splinedrive/gf180mcu-kianv-pcb/3dmodels/DF40C-70DS--3DModel-STEP-1.STEP

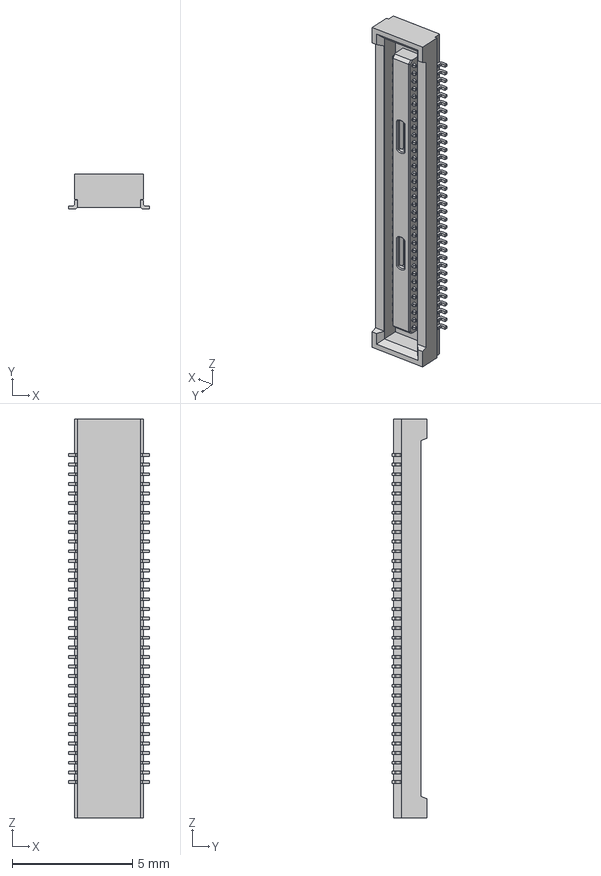
[picture p1: CAD file, 2026-02-03]
3dmodels/DF40C-70DS--3DModel-STEP-1.STEP
3.38 x 1.45 x 16.6 mm
