splinedrive/gf180mcu-kianv-pcb/3dmodels/5033981892--3DModel-STEP-1.STEP

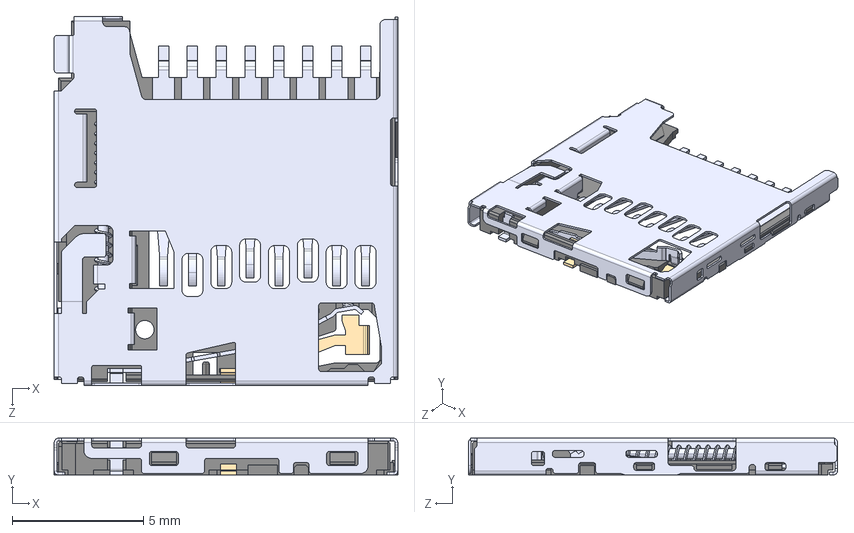
[picture p2: CAD file, 2026-02-03]
3dmodels/5033981892--3DModel-STEP-1.STEP
13.1 x 1.40 x 14.1 mm
