splinedrive/gf180mcu-kianv-pcb/3dmodels/2201778-1--3DModel-STEP-78480.STEP

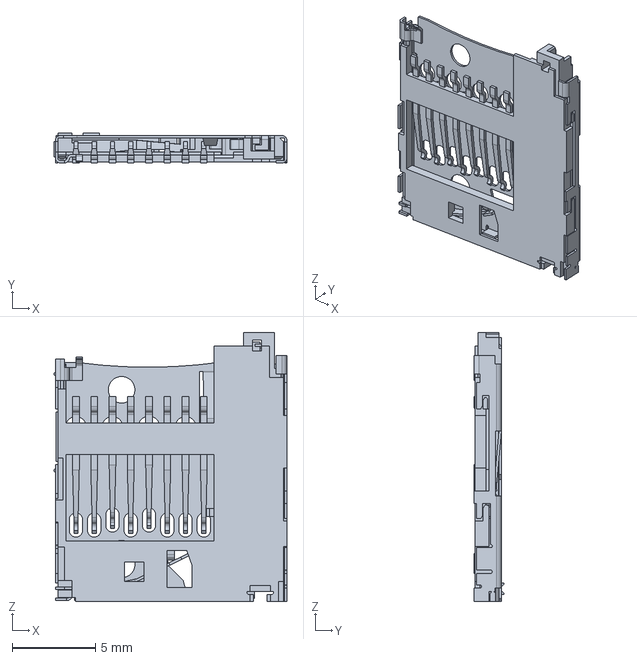
[picture p3: CAD file, 2026-02-03]
3dmodels/2201778-1--3DModel-STEP-78480.STEP
14.0 x 1.80 x 16.2 mm
