splinedrive/gf180mcu-kianv-pcb/gf180mcu-linux-KianV-SoC.kicad_pcb

## KiCad design gf180mcu-linux-KianV-SoC.kicad_pcb (2026-06-17)

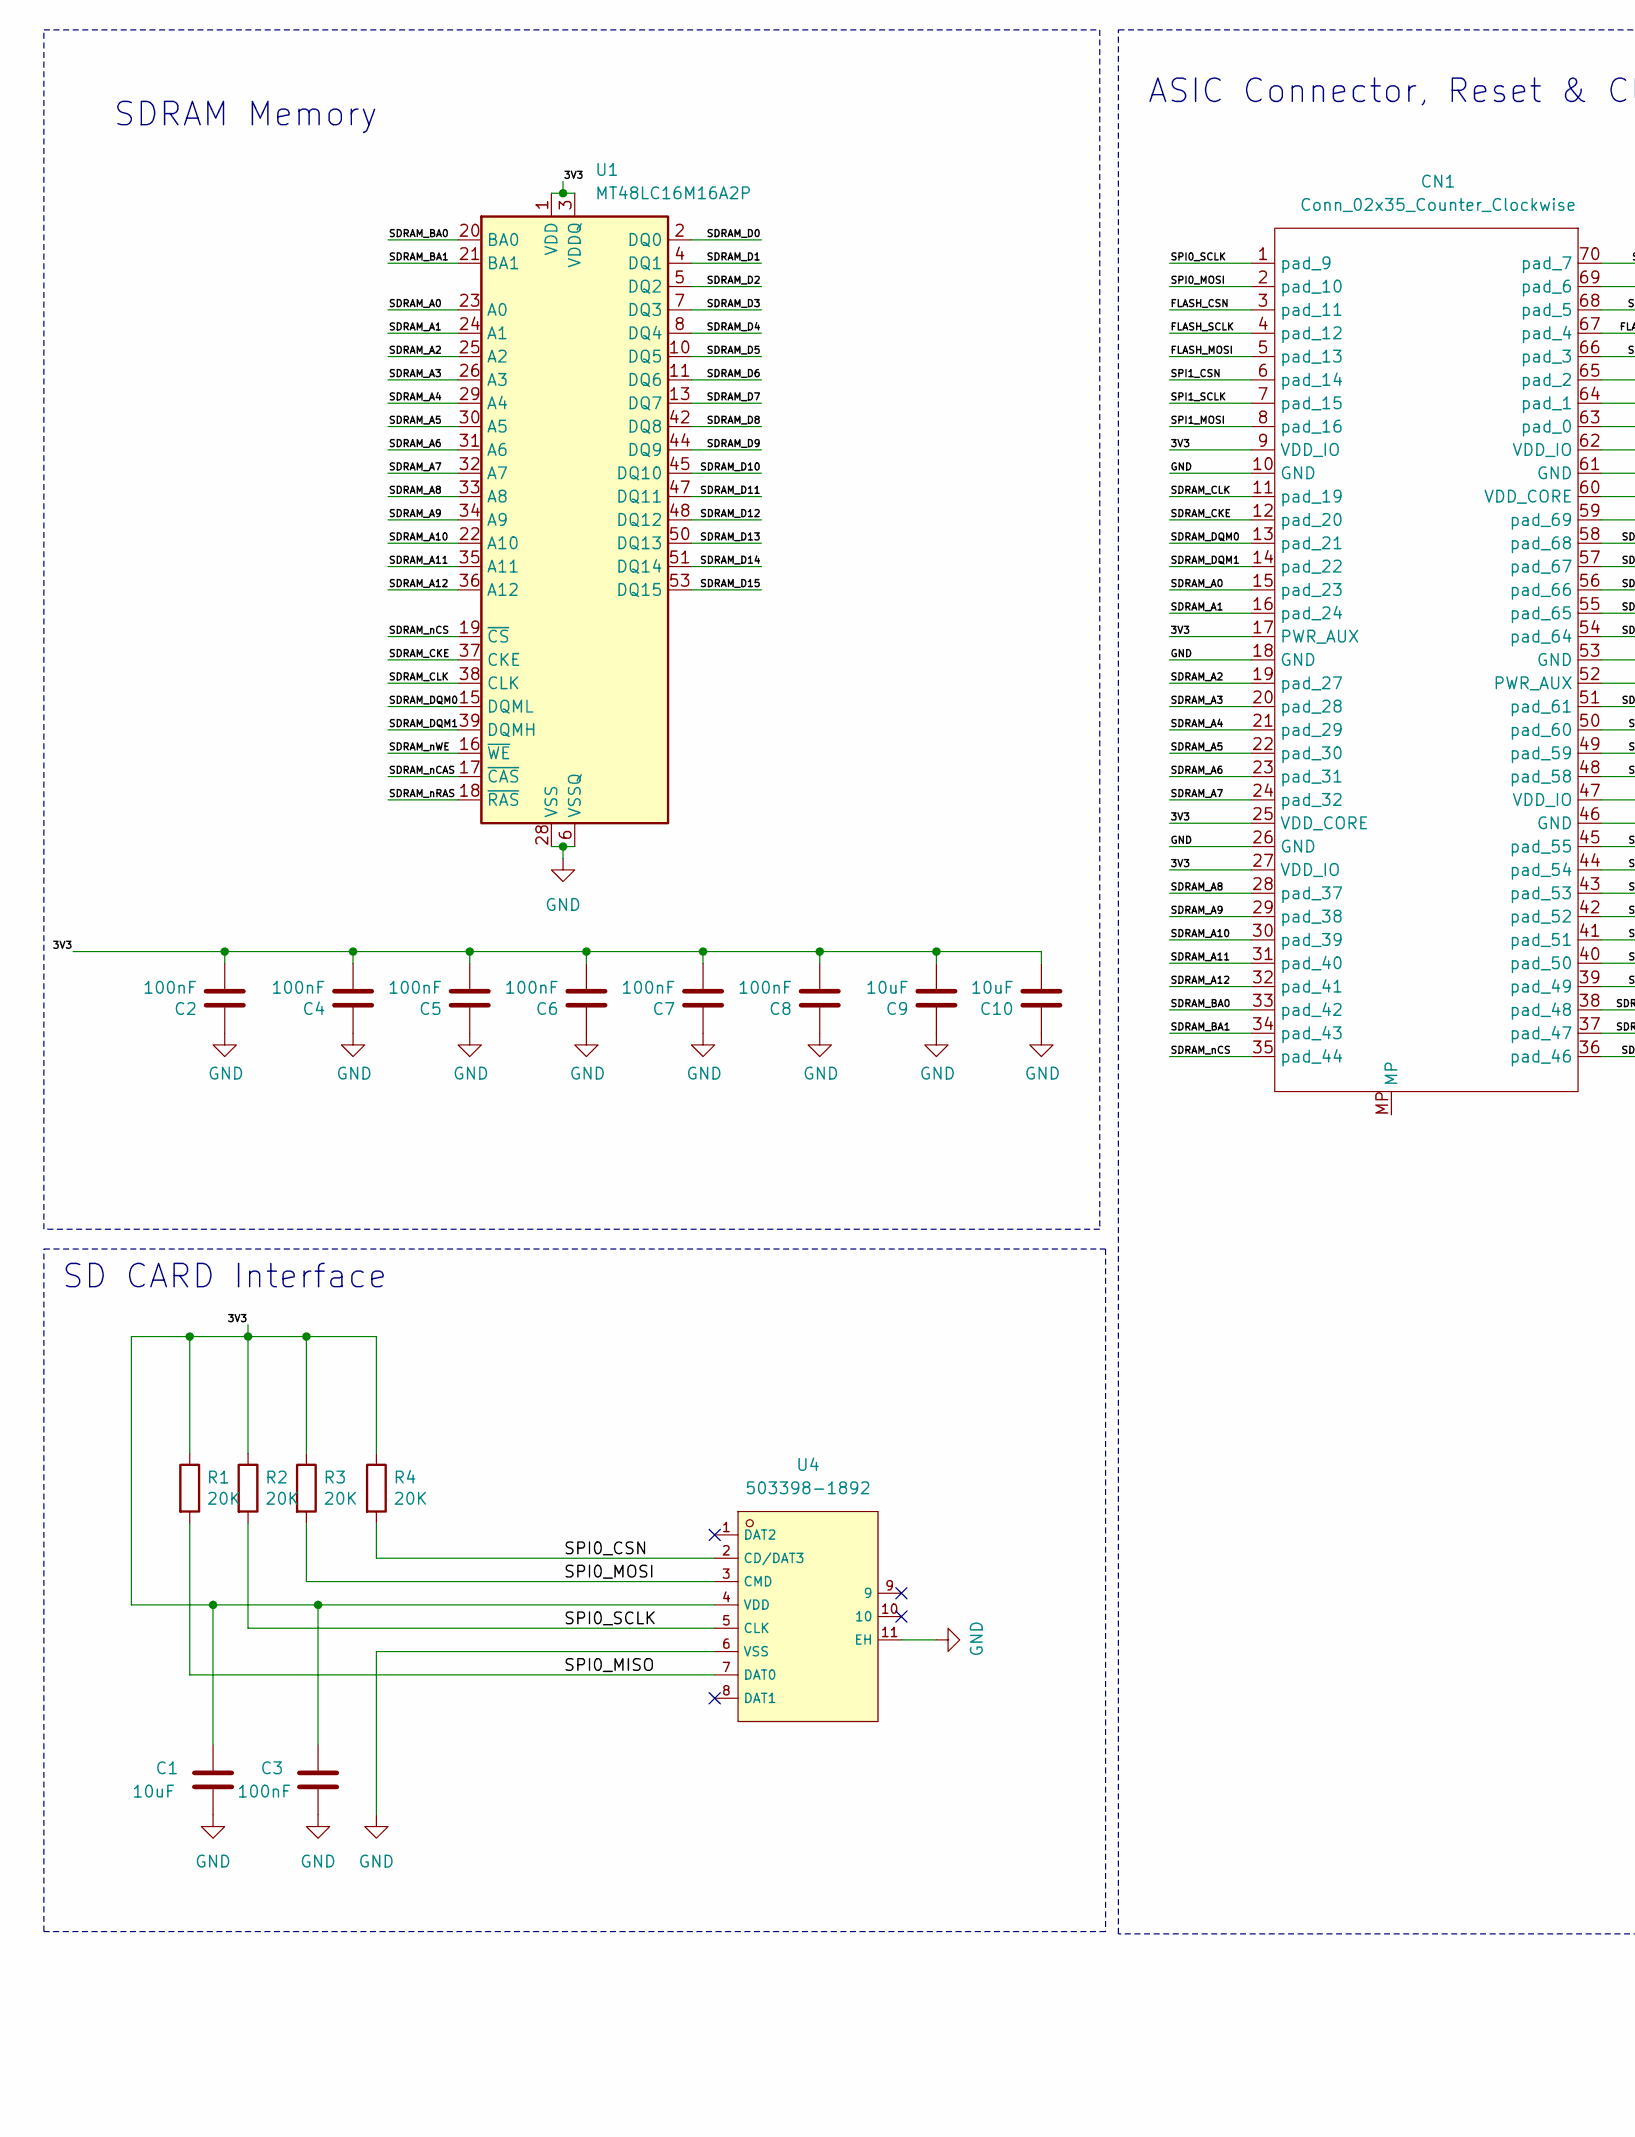
[picture p4: schematic gf180mcu-linux-KianV-SoC.kicad_sch, part in row 1, column 1]

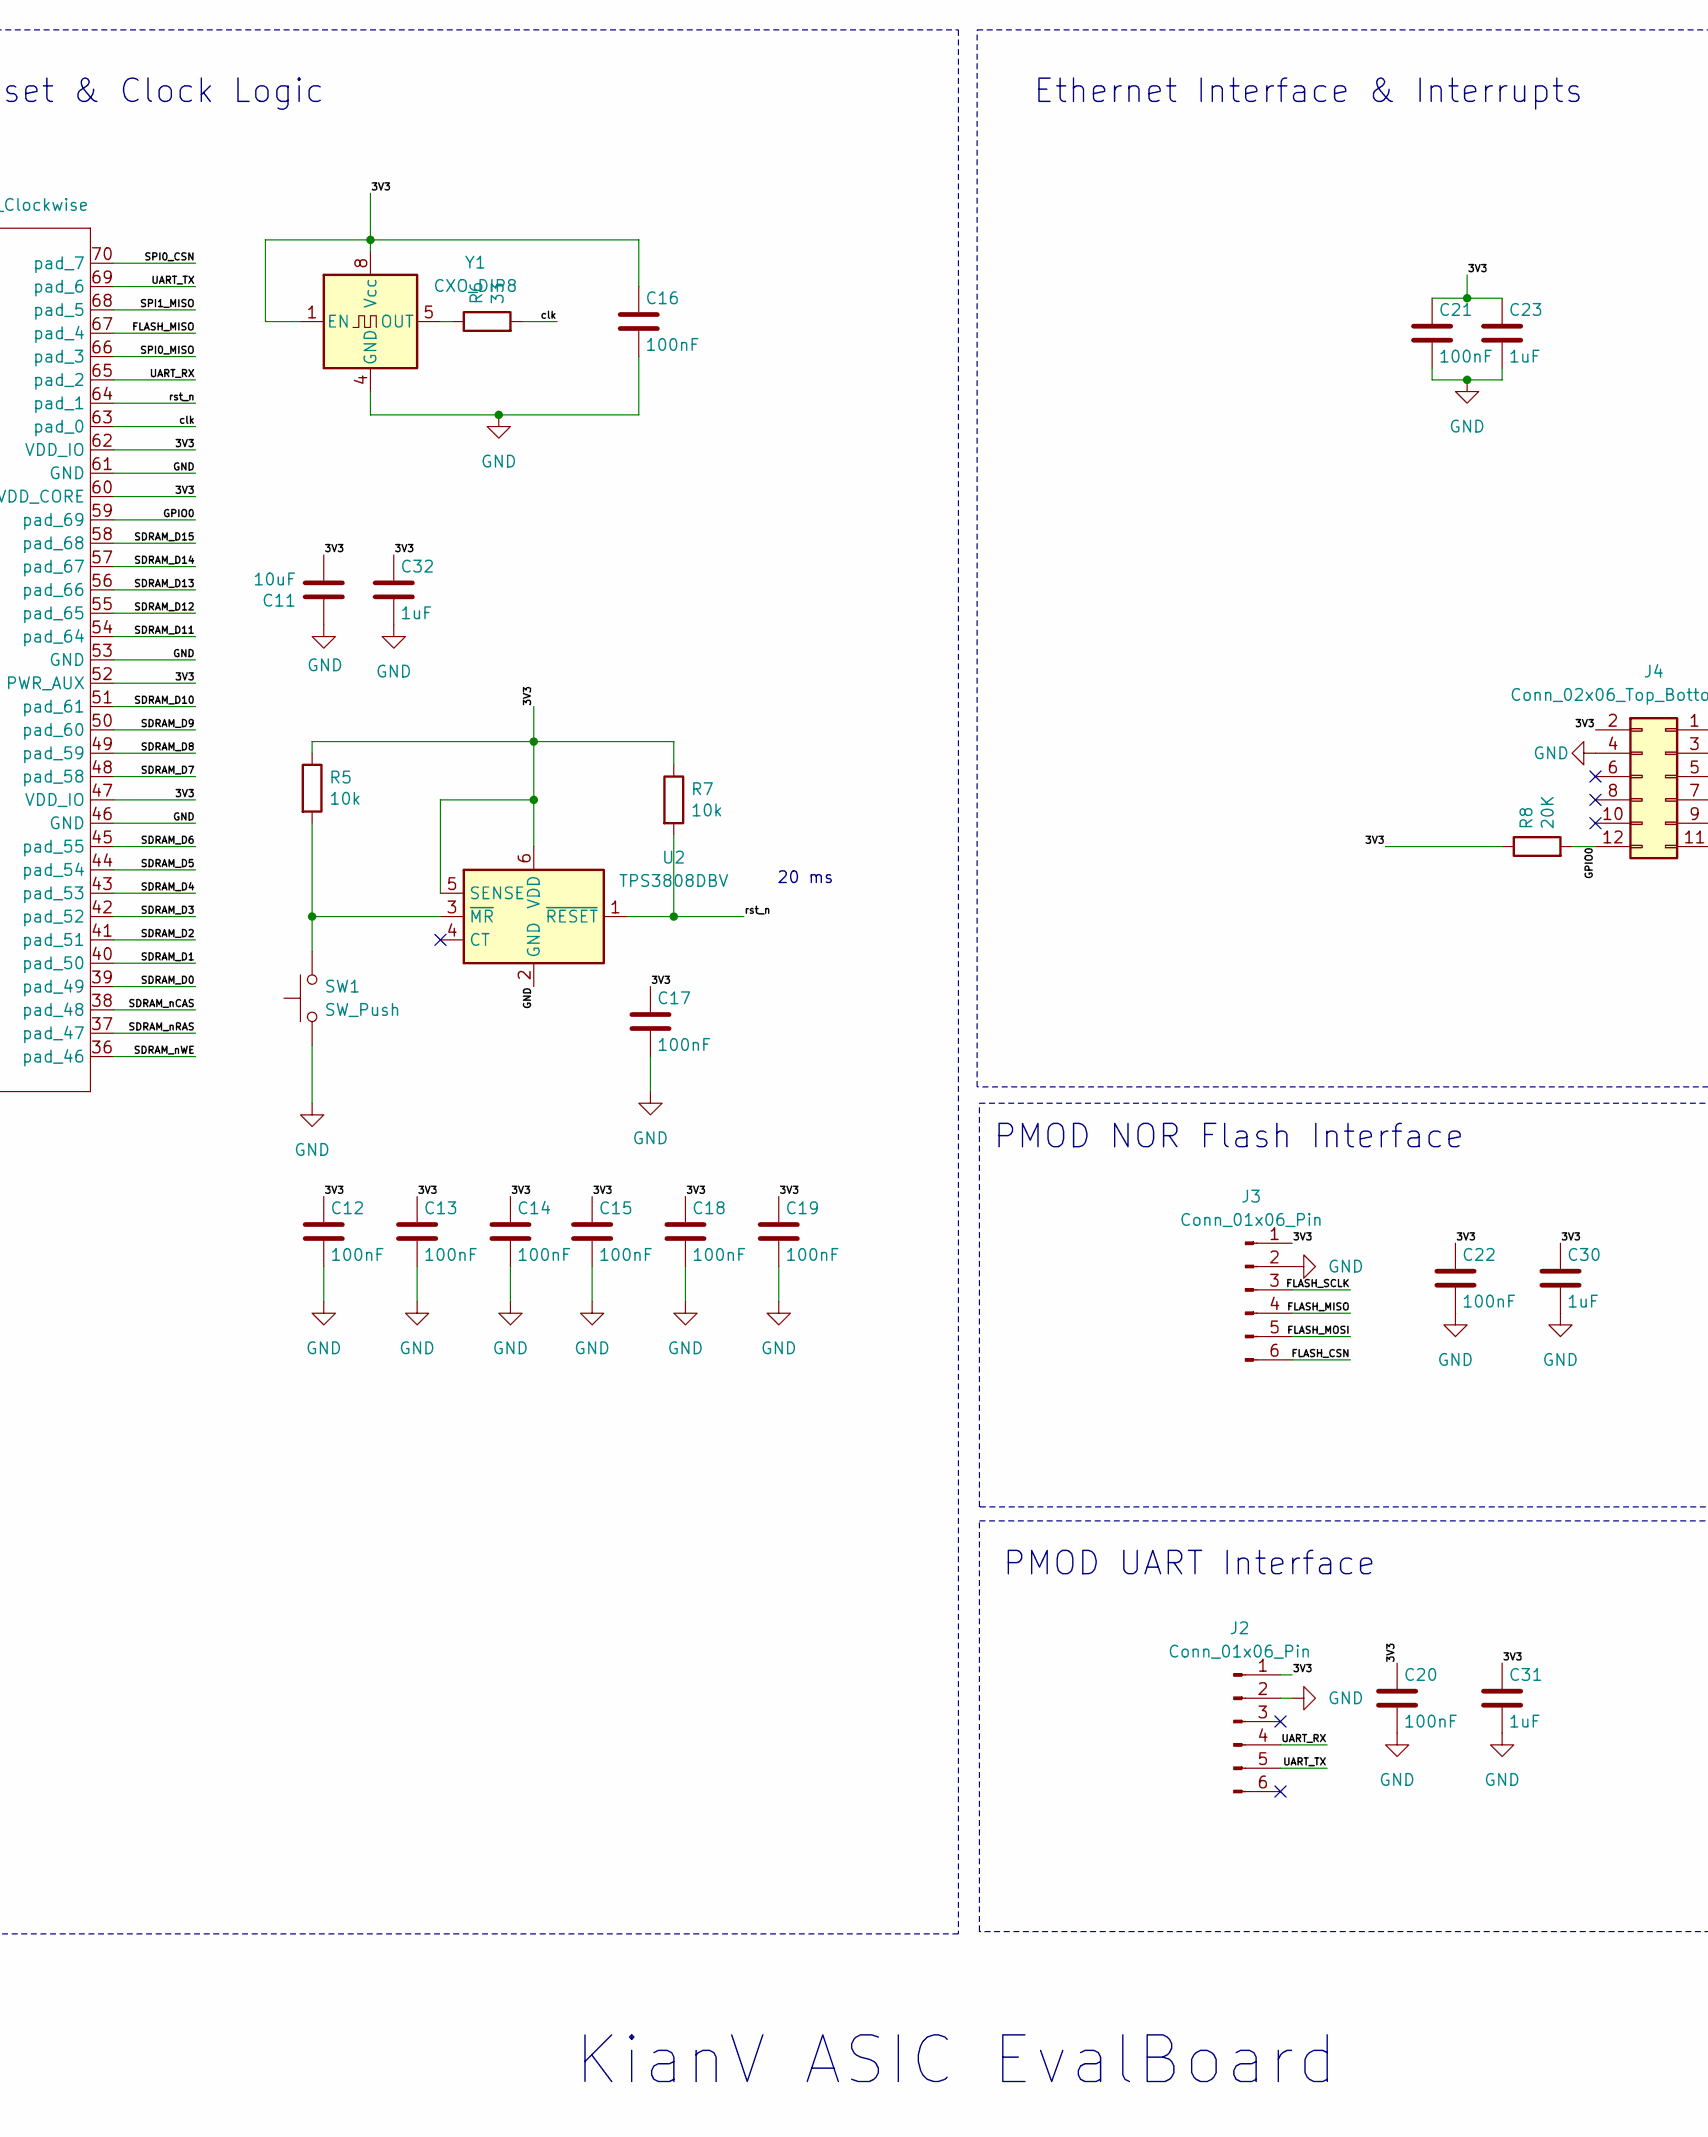
[picture p5: schematic gf180mcu-linux-KianV-SoC.kicad_sch, part in row 1, column 2]

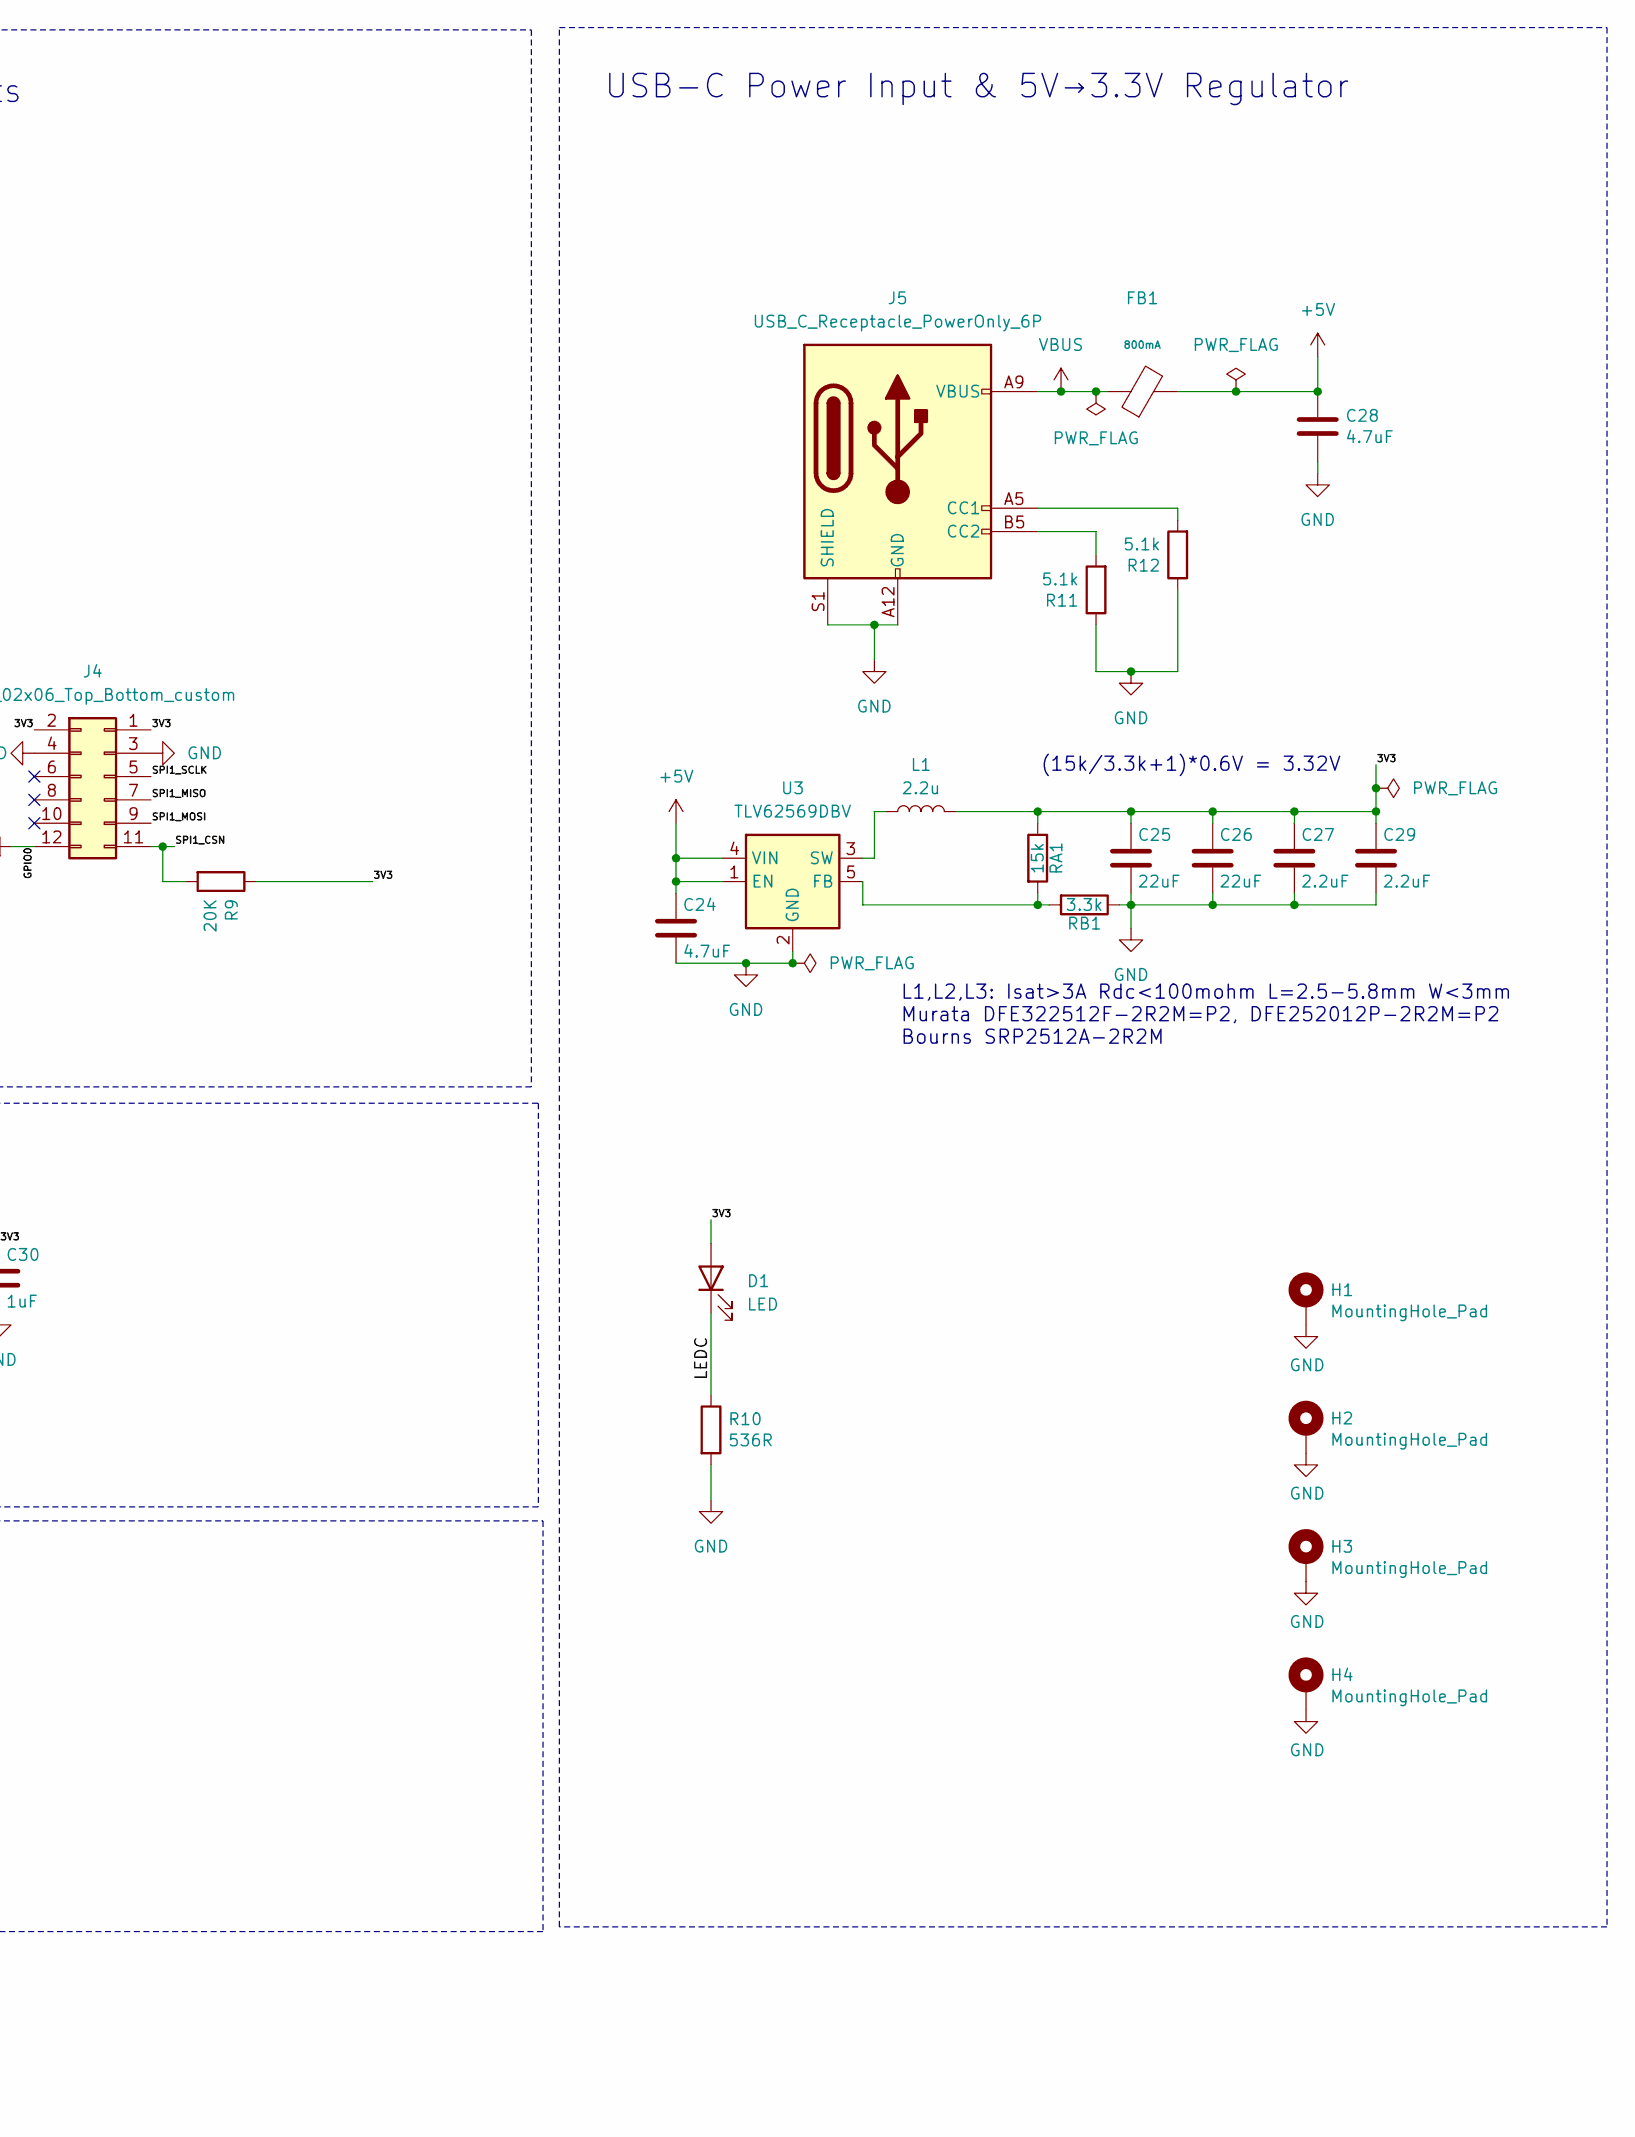
[picture p6: schematic gf180mcu-linux-KianV-SoC.kicad_sch, part in row 1, column 3]

Parts:
C1: 10uF; C_0603
C2, C3, C4, C5, C6, C7, C8: 100nF; C_0603_1608Metric
C9, C10, C11: 10uF; C_0603_1608Metric
C12, C13, C14, C15, C16, C17, C18, C19, C20, C21, C22: 100nF; C_0603_1608Metric; MPN CX0603MRX7R8BB223
C23, C30, C31, C32: 1uF; C_0603_1608Metric; MPN CX0603MRX7R8BB223
C24: 4.7uF; C_0805_2012Metric
C25, C26: 22uF; C_0805_2012Metric
C27, C29: 2.2uF; C_0805_2012Metric
C28: 4.7uF; C_0603_1608Metric
CN1: Conn_02x35_Counter_Clockwise; CONN-SMD_70P-P0.40_HC-PBB40C-70DS-0.4V-3.0-02
D1: LED; LED_0805_2012Metric
FB1: FB_0805; Current Rating 800mA; Tolerance ±25%; Part GZ2012D101TF; LCSC C1015
H1, H2, H3, H4: MountingHole_Pad; MountingHole_3.2mm_M3_Pad
J2, J3: Conn_01x06_Pin; PinSocket_1x06_P2.54mm_Horizontal
J4: Conn_02x06_Top_Bottom_custom; PinSocket_2x06_P2.54mm_Horizontal
J5: USB_C_Receptacle_PowerOnly_6P; USB_C_Receptacle_GCT_USB4125-xx-x-0190_6P_TopMnt_Horizontal
L1: 2.2u; L_0805_2012Metric
R1, R2, R3, R4, R8, R9: 20K; R_0603_1608Metric
R5, R7: 10k; R_0603_1608Metric
R6: 33; R_0603_1608Metric
R10: 536R; R_0603_1608Metric
R11, R12: 5.1k; R_0603_1608Metric
RA1: 15k; R_0603_1608Metric
RB1: 3.3k; R_0603_1608Metric; MPN RT0603FRE073K3L; Mouser 603-RC0603FR-073K3L
SW1: SW_Push; SW_PUSH_6mm_H5mm
U1: MT48LC16M16A2P; TSOP-II-54_22.2x10.16mm_P0.8mm
U2: TPS3808DBV; SOT-23-6
U3: TLV62569DBV; SOT-23-5
U4: 503398-1892; TF-SMD_503398-1892; LCSC C428492
Y1: CXO_DIP8; DIP-8_W7.62mm_Socket

Connections:
+5V: C24.1, C28.1, FB1.2, U3.1 (EN), U3.4 (VIN)
/3V3: C1.1, C2.2, C3.1, C4.2, C5.2, C6.2, C7.2, C8.2, C9.2, C10.2, C11.2, C12.1, C13.1, C14.1, C15.1, C16.1, C17.1, C18.1, C19.1, C20.1, C21.1, C22.1, C23.1, C25.1, C26.1, C27.1, C29.1, C30.1, C31.1, C32.1, CN1.9 (VDD_IO), CN1.17 (PWR_AUX), CN1.25 (VDD_CORE), CN1.27 (VDD_IO), CN1.47 (VDD_IO), CN1.52 (PWR_AUX), CN1.60 (VDD_CORE), CN1.62 (VDD_IO), D1.2 (A), J2.1, J3.1, J4.1, J4.2, L1.2, R1.1, R2.1, R3.1, R4.1, R5.1, R7.1, R8.1, R9.1, RA1.1, U1.1 (VDD), U1.3 (VDDQ), U1.9 (VDDQ), U1.14 (VDD), U1.27 (VDD), U1.43 (VDDQ), U1.49 (VDDQ), U2.5 (SENSE), U2.6 (VDD), U4.4 (VDD), Y1.1 (EN), Y1.8 (Vcc)
/FLASH_CSN: CN1.3 (pad_11), J3.6
/FLASH_MISO: CN1.67 (pad_4), J3.4
/FLASH_MOSI: CN1.5 (pad_13), J3.5
/FLASH_SCLK: CN1.4 (pad_12), J3.3
/GPIO0: CN1.59 (pad_69), J4.12, R8.2
/LEDC: D1.1 (K), R10.1
/SDRAM_A0: CN1.15 (pad_23), U1.23 (A0)
/SDRAM_A1: CN1.16 (pad_24), U1.24 (A1)
/SDRAM_A2: CN1.19 (pad_27), U1.25 (A2)
/SDRAM_A3: CN1.20 (pad_28), U1.26 (A3)
/SDRAM_A4: CN1.21 (pad_29), U1.29 (A4)
/SDRAM_A5: CN1.22 (pad_30), U1.30 (A5)
/SDRAM_A6: CN1.23 (pad_31), U1.31 (A6)
/SDRAM_A7: CN1.24 (pad_32), U1.32 (A7)
/SDRAM_A8: CN1.28 (pad_37), U1.33 (A8)
/SDRAM_A9: CN1.29 (pad_38), U1.34 (A9)
/SDRAM_A10: CN1.30 (pad_39), U1.22 (A10)
/SDRAM_A11: CN1.31 (pad_40), U1.35 (A11)
/SDRAM_A12: CN1.32 (pad_41), U1.36 (A12)
/SDRAM_BA0: CN1.33 (pad_42), U1.20 (BA0)
/SDRAM_BA1: CN1.34 (pad_43), U1.21 (BA1)
/SDRAM_CKE: CN1.12 (pad_20), U1.37 (CKE)
/SDRAM_CLK: CN1.11 (pad_19), U1.38 (CLK)
/SDRAM_D0: CN1.39 (pad_49), U1.2 (DQ0)
/SDRAM_D1: CN1.40 (pad_50), U1.4 (DQ1)
/SDRAM_D2: CN1.41 (pad_51), U1.5 (DQ2)
/SDRAM_D3: CN1.42 (pad_52), U1.7 (DQ3)
/SDRAM_D4: CN1.43 (pad_53), U1.8 (DQ4)
/SDRAM_D5: CN1.44 (pad_54), U1.10 (DQ5)
/SDRAM_D6: CN1.45 (pad_55), U1.11 (DQ6)
/SDRAM_D7: CN1.48 (pad_58), U1.13 (DQ7)
/SDRAM_D8: CN1.49 (pad_59), U1.42 (DQ8)
/SDRAM_D9: CN1.50 (pad_60), U1.44 (DQ9)
/SDRAM_D10: CN1.51 (pad_61), U1.45 (DQ10)
/SDRAM_D11: CN1.54 (pad_64), U1.47 (DQ11)
/SDRAM_D12: CN1.55 (pad_65), U1.48 (DQ12)
/SDRAM_D13: CN1.56 (pad_66), U1.50 (DQ13)
/SDRAM_D14: CN1.57 (pad_67), U1.51 (DQ14)
/SDRAM_D15: CN1.58 (pad_68), U1.53 (DQ15)
/SDRAM_DQM0: CN1.13 (pad_21), U1.15 (DQML)
/SDRAM_DQM1: CN1.14 (pad_22), U1.39 (DQMH)
/SDRAM_nCAS: CN1.38 (pad_48), U1.17 (~CAS)
/SDRAM_nCS: CN1.35 (pad_44), U1.19 (~CS)
/SDRAM_nRAS: CN1.37 (pad_47), U1.18 (~RAS)
/SDRAM_nWE: CN1.36 (pad_46), U1.16 (~WE)
/SPI0_CSN: CN1.70 (pad_7), R4.2, U4.2 (CD/DAT3)
/SPI0_MISO: CN1.66 (pad_3), R1.2, U4.7 (DAT0)
/SPI0_MOSI: CN1.2 (pad_10), R3.2, U4.3 (CMD)
/SPI0_SCLK: CN1.1 (pad_9), R2.2, U4.5 (CLK)
/SPI1_CSN: CN1.6 (pad_14), J4.11, R9.2
/SPI1_MISO: CN1.68 (pad_5), J4.7
/SPI1_MOSI: CN1.8 (pad_16), J4.9
/SPI1_SCLK: CN1.7 (pad_15), J4.5
/UART_RX: CN1.65 (pad_2), J2.4
/UART_TX: CN1.69 (pad_6), J2.5
/clk: CN1.63 (pad_0), R6.2
/rst_n: CN1.64 (pad_1), R7.2, U2.1 (~RESET)
GND: C1.2, C2.1, C3.2, C4.1, C5.1, C6.1, C7.1, C8.1, C9.1, C10.1, C11.1, C12.2, C13.2, C14.2, C15.2, C16.2, C17.2, C18.2, C19.2, C20.2, C21.2, C22.2, C23.2, C24.2, C25.2, C26.2, C27.2, C28.2, C29.2, C30.2, C31.2, C32.2, CN1.10 (GND), CN1.18 (GND), CN1.26 (GND), CN1.46 (GND), CN1.53 (GND), CN1.61 (GND), H1.1 (1_1), H2.1 (1_1), H3.1 (1_1), H4.1 (1_1), J2.2, J3.2, J4.3, J4.4, J5.A12 (GND), J5.B12 (GND), J5.S1 (SHIELD), R10.2, R11.1, R12.1, RB1.1, SW1.1, U1.6 (VSSQ), U1.12 (VSSQ), U1.28 (VSS), U1.41 (VSS), U1.46 (VSSQ), U1.52 (VSSQ), U1.54 (VSS), U2.2 (GND), U3.2 (GND), U4.6 (VSS), U4.11 (EH), Y1.4 (GND)
unnamed: J5.A5 (CC1), R12.2
unnamed: J5.B5 (CC2), R11.2
unnamed: R5.2, SW1.2, U2.3 (~MR)
unnamed: RA1.2, RB1.2, U3.5 (FB)
unnamed: L1.1, U3.3 (SW)
unnamed: R6.1, Y1.5 (OUT)
VBUS: FB1.1, J5.A9 (VBUS), J5.B9 (VBUS)

Notes on the sheet:
(15k/3.3k+1)*0.6V = 3.32V
USB-C Power Input & 5V→3.3V Regulator
20 ms
L1,L2,L3: Isat>3A Rdc<100mohm L=2.5-5.8mm W<3mm Murata DFE322512F-2R2M=P2, DFE252012P-2R2M=P2 Bourns SRP2512A-2R2M
KianV ASIC EvalBoard
PMOD NOR Flash Interface
ASIC Connector, Reset & Clock Logic
Ethernet Interface & Interrupts
PMOD UART Interface
SD CARD Interface
SDRAM Memory

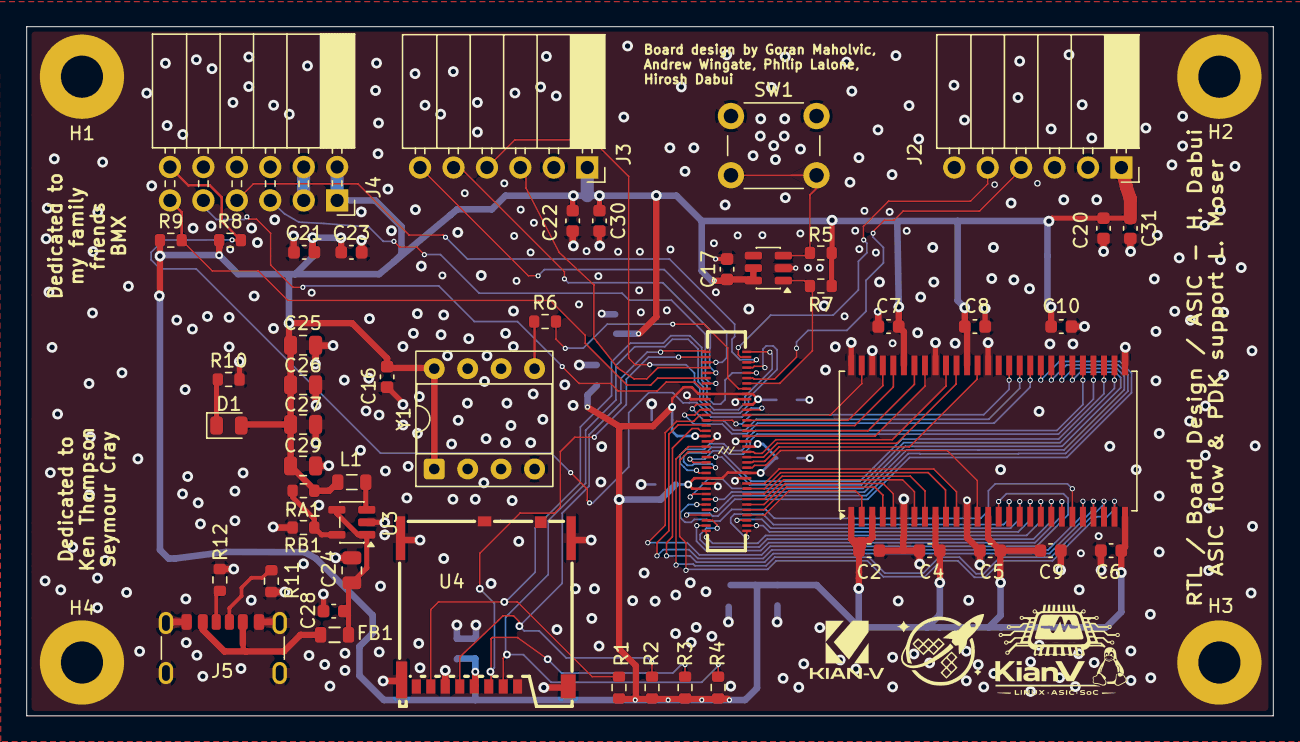
[picture p7: board gf180mcu-linux-KianV-SoC.kicad_pcb from above]

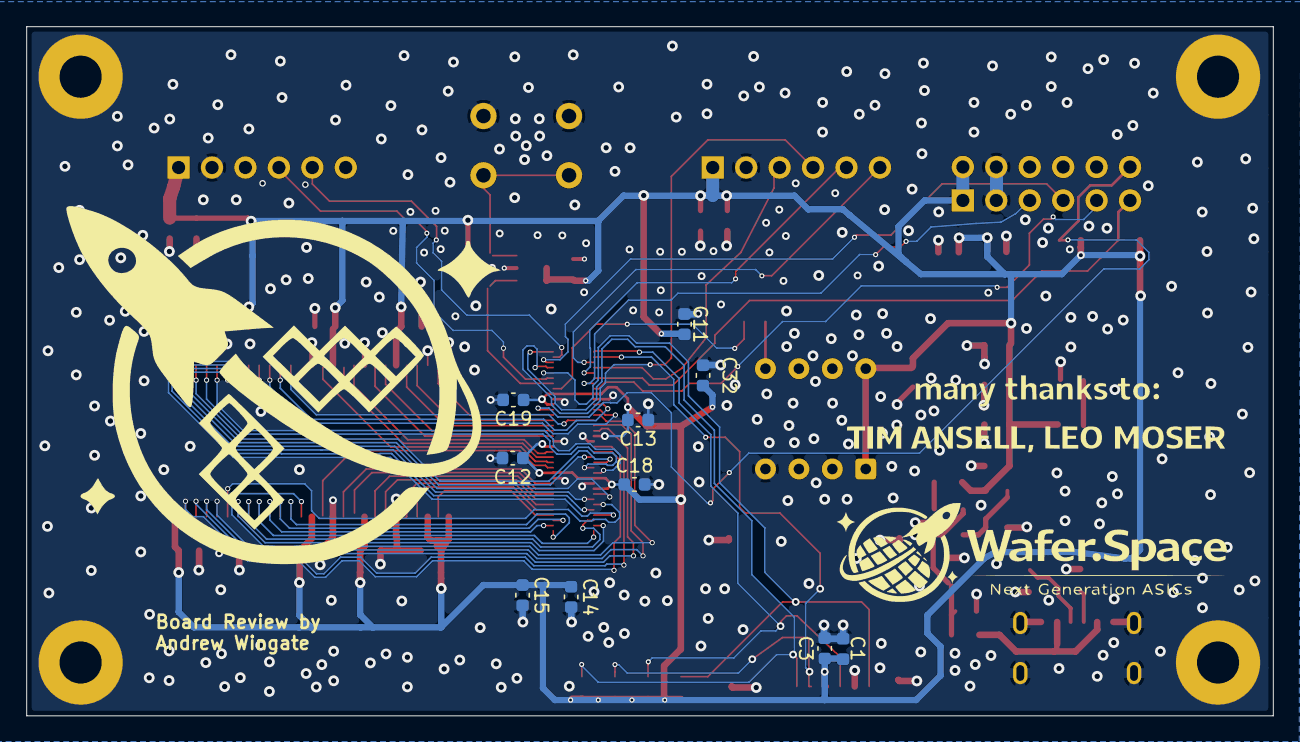
[picture p8: board gf180mcu-linux-KianV-SoC.kicad_pcb from below]

Board: 4 copper layers, 94.7 x 52.4 mm, 64 parts (10 on the bottom side), 67 nets.
