splinedrive/gf180mcu-kianv-pcb/(commit log)

2026-01-10 Add KiCad project (gf180mcu-linux-KianV-SoC)
    [gf180mcu-linux-KianV-SoC.kicad_pcb, gf180mcu-linux-KianV-SoC.kicad_sch]
2026-01-11 fixed sdcard
    [gf180mcu-linux-KianV-SoC.kicad_pcb]
2026-01-11 rework: silk
    [gf180mcu-linux-KianV-SoC.kicad_pcb]
2026-01-15 small tweaks
    [gf180mcu-linux-KianV-SoC.kicad_pcb]
2026-01-15 first pass complete
    [gf180mcu-linux-KianV-SoC.kicad_pcb]
2026-01-15 rework: silk text, sdram cap gnd, power lines, ...
    [gf180mcu-linux-KianV-SoC.kicad_pcb]
2026-01-16 more comments
    [gf180mcu-linux-KianV-SoC.kicad_pcb]
2026-01-20 kicad: fix capacitor footprints + add GND stitching vias
    Switch C1/C3/C28 from resistor footprints to proper 0603 capacitor footprints (C1 to JLCPCB lib + 3D model)
    Tweak pad sizes/placement + silkscreen/ref visibility
    Add additional GND vias for stitching and minor route/via coordinate cleanup
    [gf180mcu-linux-KianV-SoC.kicad_pcb, gf180mcu-linux-KianV-SoC.kicad_sch]
2026-01-21 andrew's small tweaks
    [gf180mcu-linux-KianV-SoC.kicad_pcb]
2026-02-03 pcb: DFM cleanup, SD card footprint update, oscillator fixes
    [2201778-1--3DModel-STEP-78480.STEP, 5033981892--3DModel-STEP-1.STEP, DF40C-70DS--3DModel-STEP-1.STEP, gf180mcu-linux-KianV-SoC.kicad_pcb, gf180mcu-linux-KianV-SoC.kicad_sch]
2026-06-10 update connector assigments and reroute
    [gf180mcu-linux-KianV-SoC.kicad_pcb, gf180mcu-linux-KianV-SoC.kicad_sch]
2026-06-10 remove drc warnings, added machdyne credit
    [gf180mcu-linux-KianV-SoC.kicad_pcb]
2026-06-11 rounded vcc signal
    [gf180mcu-linux-KianV-SoC.kicad_pcb]
2026-06-17 Set C24 to 4.7uF
    [gf180mcu-linux-KianV-SoC.kicad_pcb, gf180mcu-linux-KianV-SoC.kicad_sch]
